ADXBD/A1M1900x-MOD3/README.md

# A1M1900x-MOD3
3D Print Files For the M1900x MOD3 Enclosure
