ADXBD/A1M1900x-MOD3/A1M19003 MOD3/Gasket.step

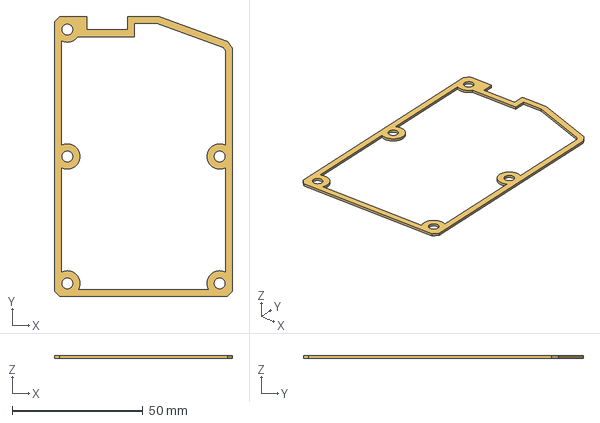
[picture p1: CAD file, 2025-04-25]
A1M19003 MOD3/Gasket.step
68.2 x 107.0 x 1.00 mm
