ADXBD/A1M1900x-MOD3/A1M1900x MOD 3 Master Files.3mf

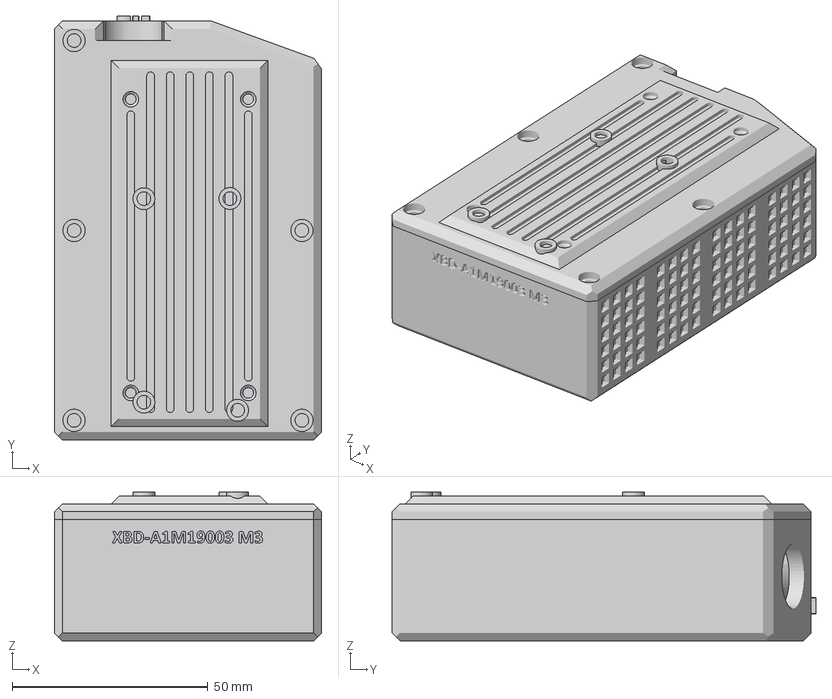
[picture p2: CAD file, 2025-04-27]
A1M1900x MOD 3 Master Files.3mf
68.2 x 108.2 x 38.0 mm
Bottom
Top w/ Light Covers
