ADXBD/A1M1900x-MOD3/A1M1900x M3 Master Fille All in One Bambu.3mf

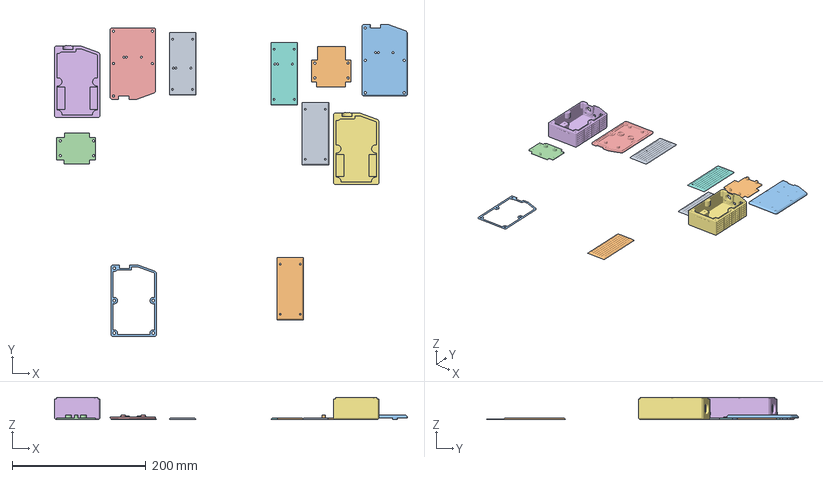
[picture p3: CAD file, 2025-04-25]
A1M1900x M3 Master Fille All in One Bambu.3mf
528.7 x 466.9 x 33.0 mm
Cover With Holes.step
Cover WithOUT Holes.step
Gasket.step
Mount Board.step
Top.step
19003 Bottom.step
19007 Bottom.step
19007 Cover With Light Ports.step
19007 Light Cover.step
19007 Mount Board.step
19007 Top.step
