ADXBD/A1M1900x-MOD3/A1M19007 MOD3/19007 Bottom.step

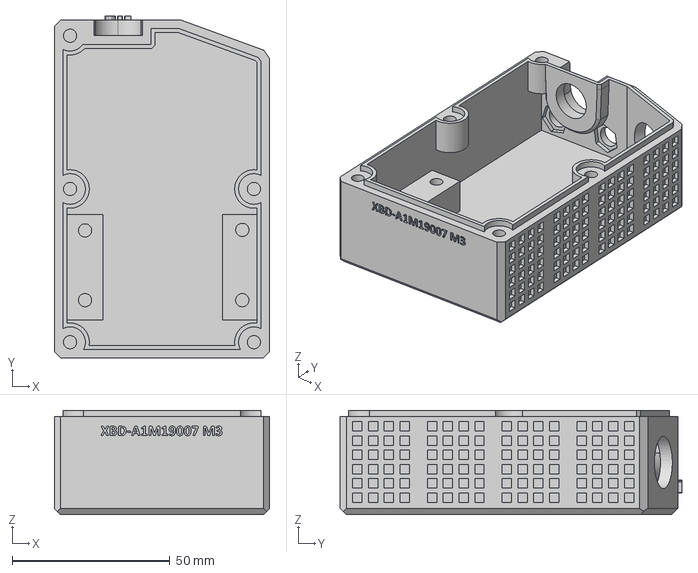
[picture p4: CAD file, 2025-04-25]
A1M19007 MOD3/19007 Bottom.step
68.2 x 108.2 x 33.0 mm
