ADXBD/A1M1900x-MOD3/A1M19003 MOD3/19003 Cover With Holes.step

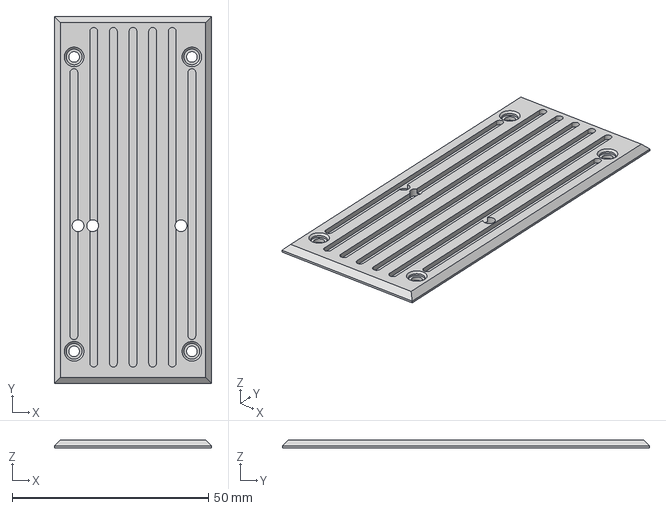
[picture p5: CAD file, 2025-04-25]
A1M19003 MOD3/19003 Cover With Holes.step
40.0 x 93.5 x 2.00 mm
