ADXBD/A1M1900x-MOD3/A1M19007 MOD3/19007 Top.step

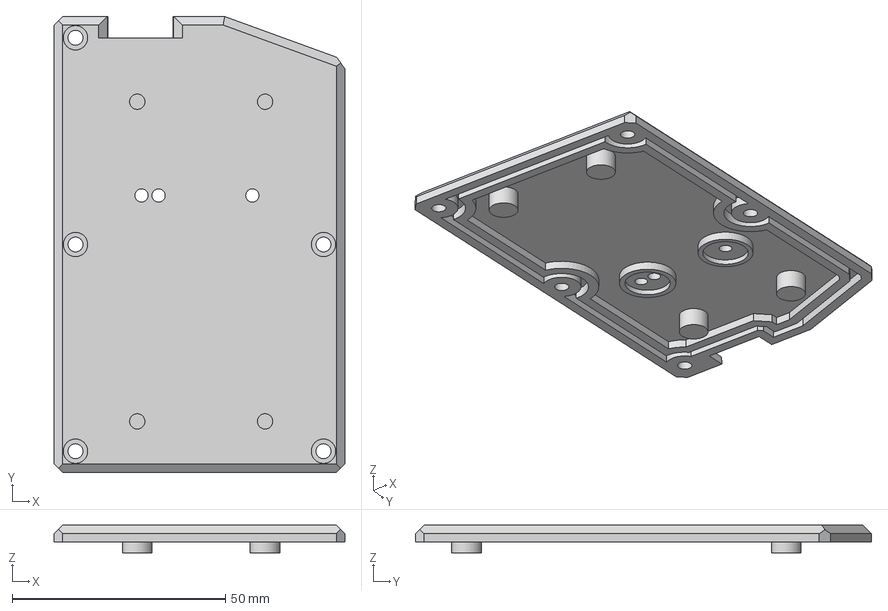
[picture p6: CAD file, 2025-04-25]
A1M19007 MOD3/19007 Top.step
68.2 x 107.0 x 6.50 mm
