ADXBD/A1M1900x-MOD3/A1M19003 MOD3/19003 Top.step

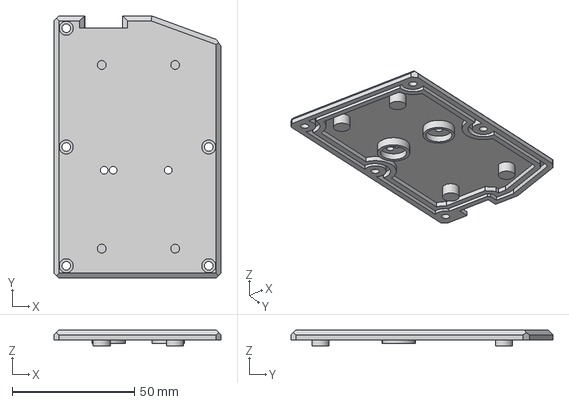
[picture p7: CAD file, 2025-04-25]
A1M19003 MOD3/19003 Top.step
68.2 x 107.0 x 6.50 mm
