ADXBD/A1M1900x-MOD3/A1M19007 MOD3/19007 Mount Board.step

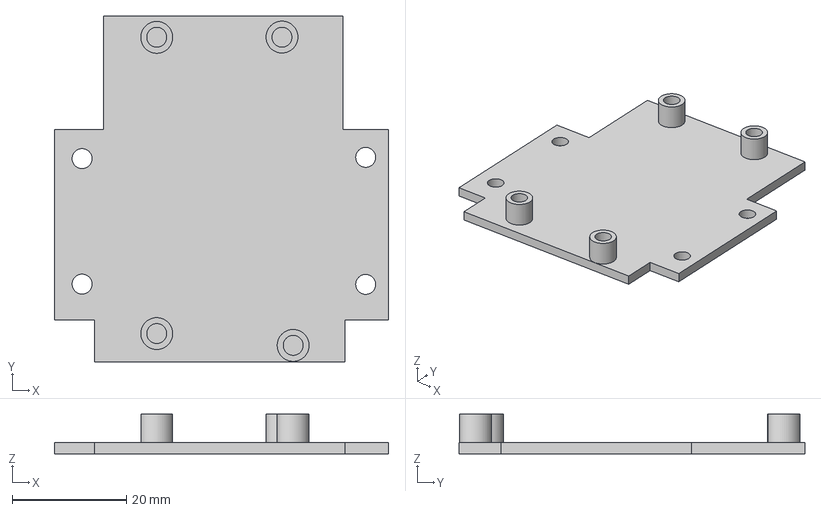
[picture p8: CAD file, 2025-04-25]
A1M19007 MOD3/19007 Mount Board.step
58.6 x 60.6 x 7.00 mm
