ADXBD/A1M1900x-MOD3/A1M19003 MOD3/19003 Mount Board.step

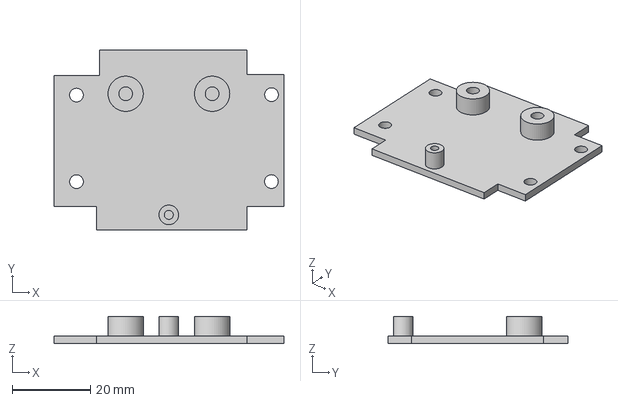
[picture p9: CAD file, 2025-04-25]
A1M19003 MOD3/19003 Mount Board.step
58.7 x 45.9 x 7.00 mm
