ADXBD/A1M1900x-MOD3/A1M19003 MOD3/19003 Cover without light Holes.step

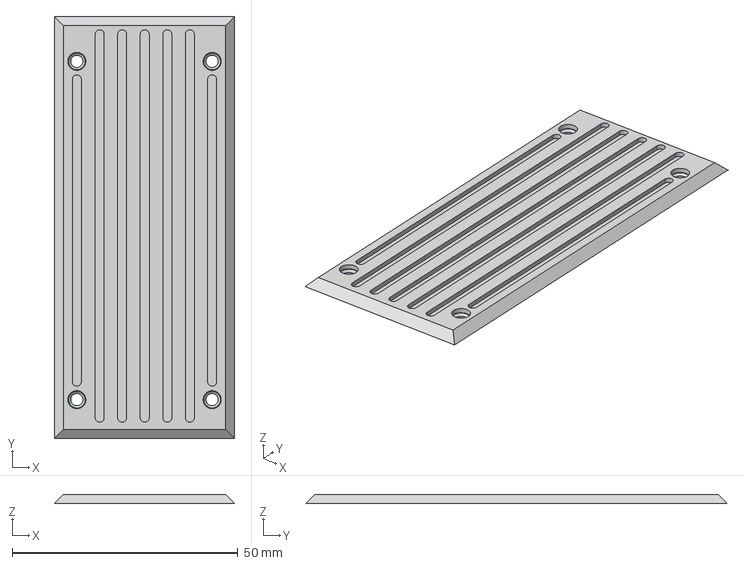
[picture p10: CAD file, 2025-04-25]
A1M19003 MOD3/19003 Cover without light Holes.step
40.0 x 93.6 x 2.00 mm
