ADXBD/A1M1900x-MOD3/(list of files, cad)

Other CAD files:
A1M19003 MOD3/19003 Bottom.step
A1M19007 MOD3/19007 Cover With Light Ports.step
A1M19007 MOD3/19007 Light Cover.step
